vladaviedov/frequency-counter/README.md

# Frequency Counter

Design files & firmware for my [frequency counter
project](https://vladaviedov.org/project/frequency_counter.html)
