vladaviedov/frequency-counter/kicad/frequency_counter.kicad_pcb

## KiCad design kicad/frequency_counter.kicad_pcb (2026-02-19)

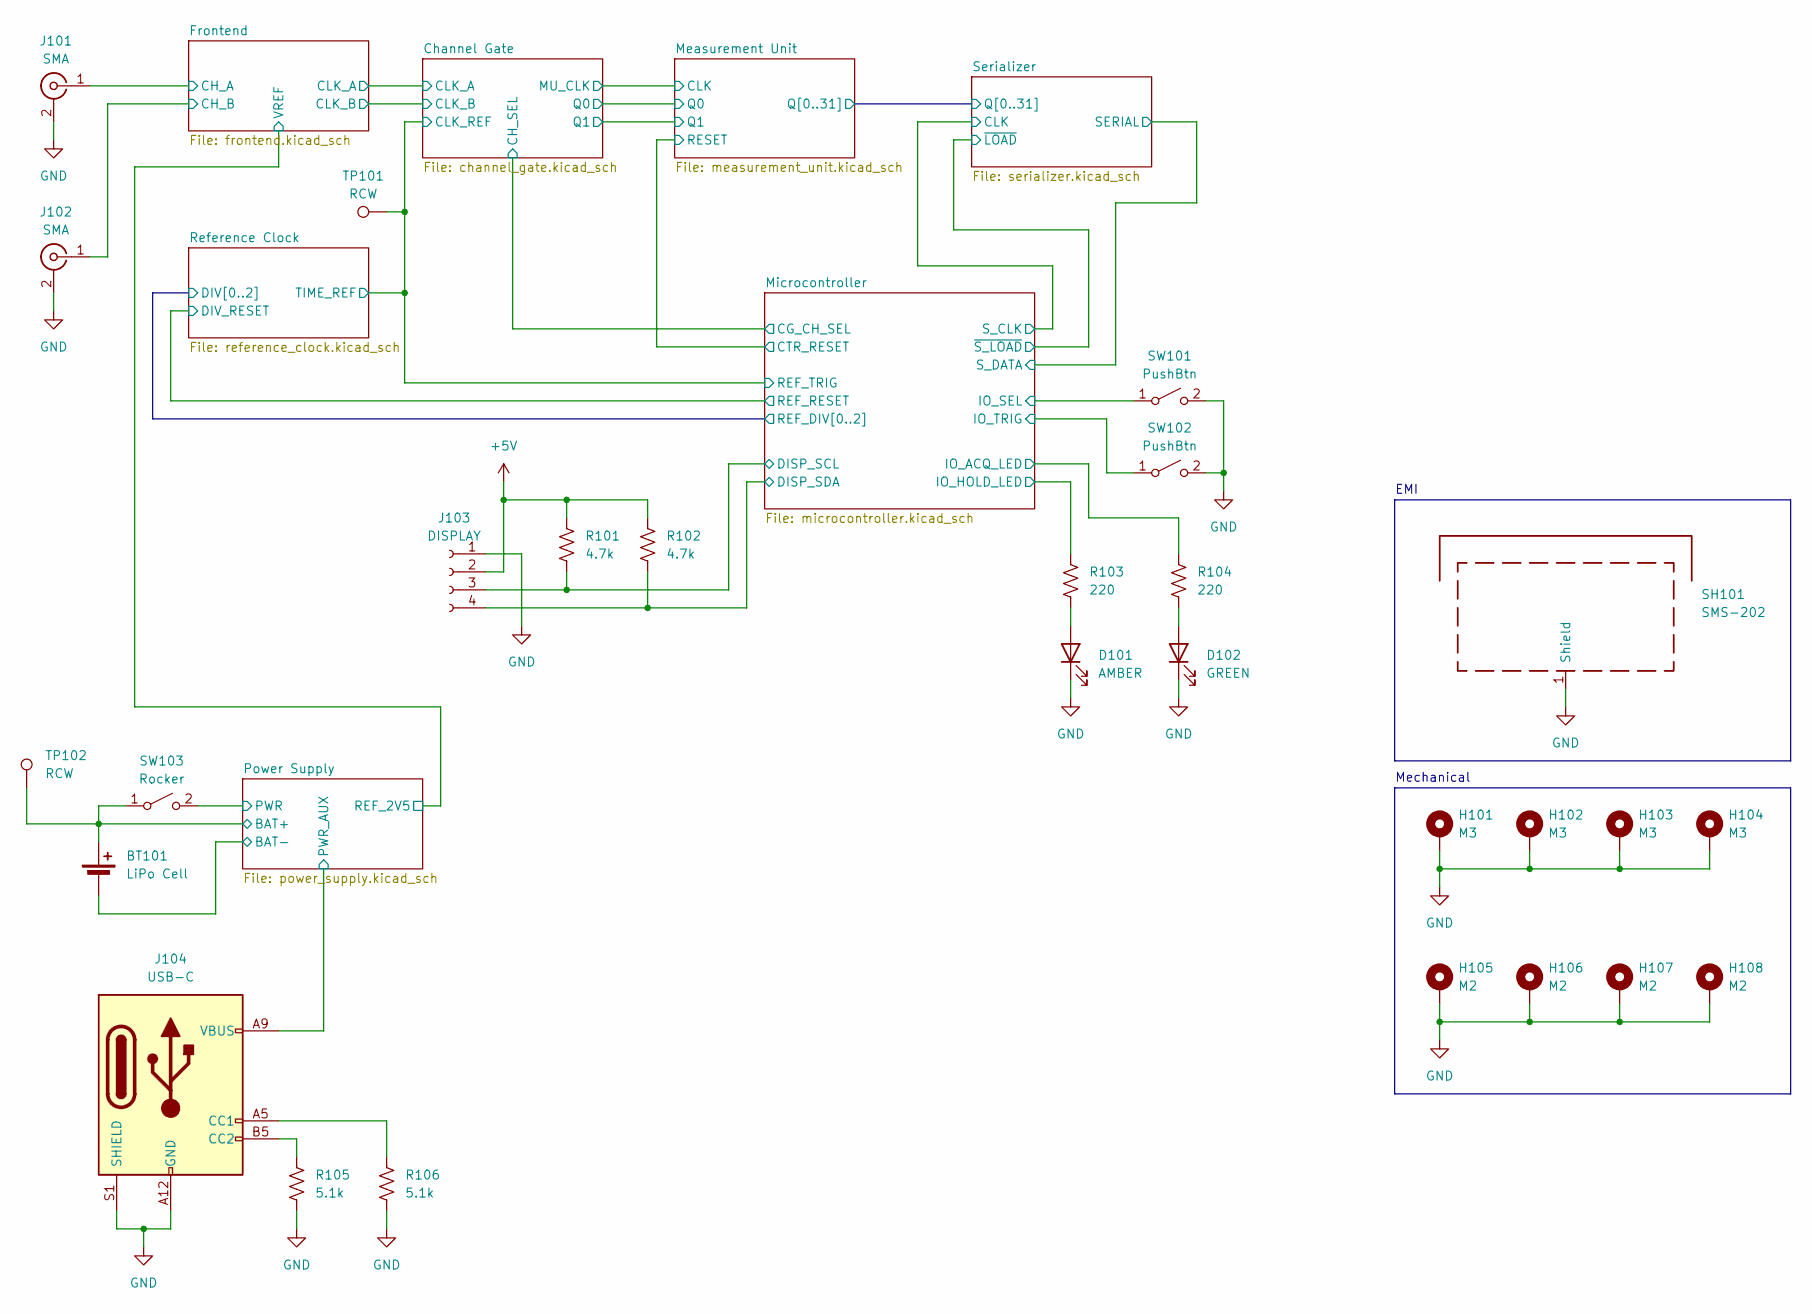
[picture p1: schematic frequency_counter.kicad_sch, Frequency Counter]

Parts:
BT101: LiPo Cell; JST_ZH_B2B-ZR_1x02_P1.50mm_Vertical
D101: AMBER; LED_0603_1608Metric; MPN B1911UY--20D000114U1930
D102: GREEN; LED_0603_1608Metric; MPN B1911NG--20D000214U1930
H101, H102, H103, H104: M3; MountingHole_3.2mm_M3_Pad
H105, H106, H107, H108: M2; MountingHole_2.2mm_M2_Pad
J101, J102: SMA; SMA_Adjusted; MPN CON-SMA-EDGE-S
J103: DISPLAY; PinHeader_1x04_P2.54mm_Vertical
J104: USB-C; USB_C_Receptacle_GCT_USB4125-xx-x_6P_TopMnt_Horizontal; MPN USB4125-GF-A
R101, R102: 4.7k; R_0402_1005Metric_Fix; MPN RC0402JR-074K7L
R103, R104: 220; R_0402_1005Metric_Fix; MPN RC0402JR-13220RL
R105, R106: 5.1k; R_0402_1005Metric_Fix; MPN RC0402JR-135K1L
SH101: SMS-202; Laird_Technologies_BMI-S-202-F_16.50x16.50mm; MPN SMS-201F
SW101, SW102: PushBtn; SW_Push_1P1T_NO_E-Switch_TL3301NxxxxxG; MPN 2-1977223-4
SW103: Rocker; SolderWire-1.5sqmm_1x02_P6mm_D1.7mm_OD3mm
TP101, TP102: RCW; TestPoint_KOA_RCW; MPN RCWCTE

Connections:
+5V: J103.2, R101.1, R102.1; also elsewhere on the board
/Channel Gate/CLK_REF: TP101.1; also elsewhere on the board
/Frontend/CH_A: J101.1 (In); also elsewhere on the board
/Frontend/CH_B: J102.1 (In); also elsewhere on the board
/Microcontroller/DISP_SCL: J103.3, R101.2; also elsewhere on the board
/Microcontroller/DISP_SDA: J103.4, R102.2; also elsewhere on the board
/Microcontroller/IO_ACQ_LED: R104.1; also elsewhere on the board
/Microcontroller/IO_HOLD_LED: R103.1; also elsewhere on the board
/Microcontroller/IO_SEL: SW101.1 (A); also elsewhere on the board
/Microcontroller/IO_TRIG: SW102.1 (A); also elsewhere on the board
/Power Supply/BAT+: BT101.1 (+), SW103.1 (A), TP102.1; also elsewhere on the board
/Power Supply/BAT-: BT101.2 (-); also elsewhere on the board
/Power Supply/PWR: SW103.2 (B); also elsewhere on the board
/Power Supply/PWR_AUX: J104.A9 (VBUS), J104.B9 (VBUS); also elsewhere on the board
GND: D101.1 (K), D102.1 (K), H101.1, H102.1, H103.1, H104.1, H105.1, H106.1, H107.1, H108.1, J101.2 (Ext), J102.2 (Ext), J103.1, J104.A12 (GND), J104.B12 (GND), J104.S1 (SHIELD), R105.2, R106.2, SH101.1 (Shield), SW101.2 (B), SW102.2 (B); also elsewhere on the board
unnamed: D101.2 (A), R103.2
unnamed: D102.2 (A), R104.2
unnamed: J104.A5 (CC1), R106.1
unnamed: J104.B5 (CC2), R105.1

Notes on the sheet:
Mechanical
EMI

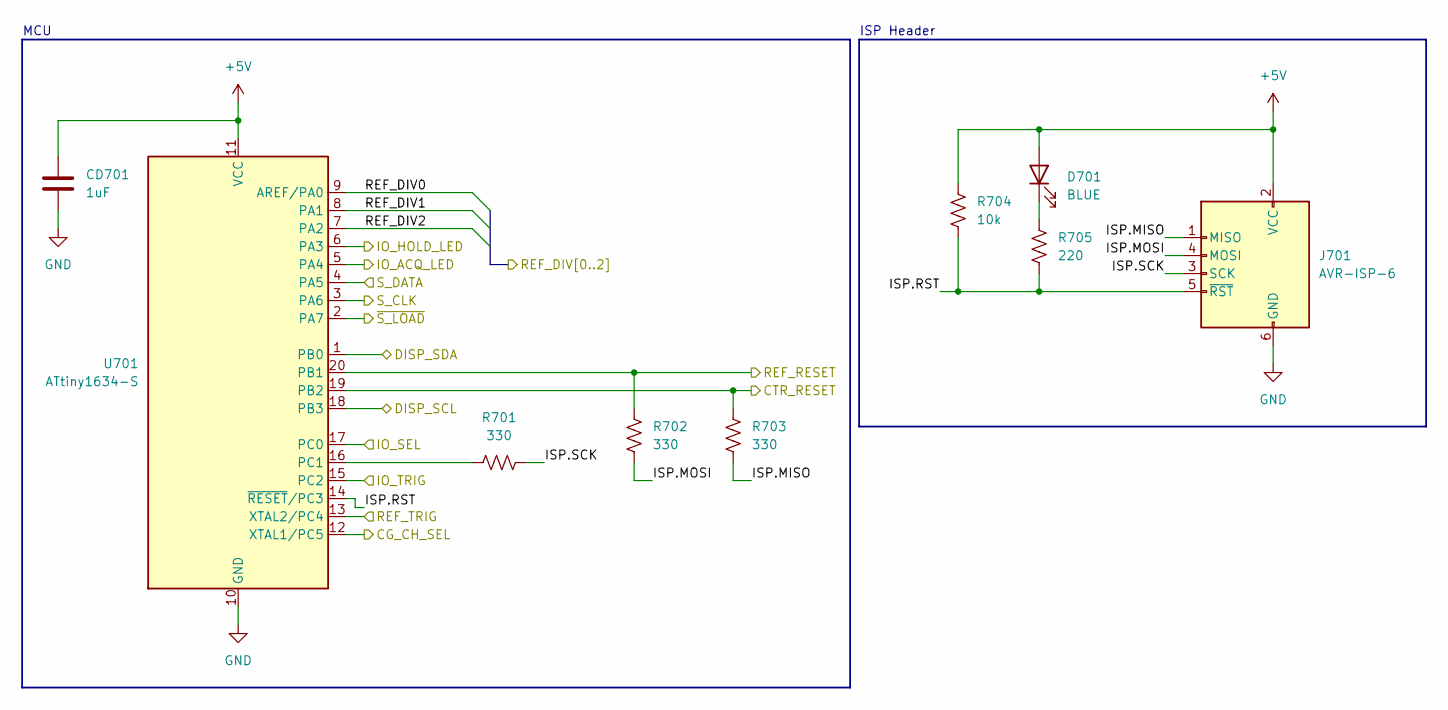
[picture p2: schematic microcontroller.kicad_sch, Frequency Counter]

Parts:
CD701: 1uF; C_0402_1005Metric_Fix; MPN 0402ZD105KAT2A
D701: BLUE; LED_0603_1608Metric; MPN E1221NB--05D000814U1930
J701: AVR-ISP-6; IDC-Header_2x03_P2.54mm_Vertical
R701, R702, R703: 330; R_0402_1005Metric_Fix; MPN RC0402JR-13330RL
R704: 10k; R_0402_1005Metric_Fix; MPN RC0402JR-1310KL
R705: 220; R_0402_1005Metric_Fix; MPN RC0402JR-13220RL
U701: ATtiny1634-S; SOIC-20W_7.5x12.8mm_P1.27mm; MPN ATTINY1634-SU

Connections:
+5V: CD701.1, D701.2 (A), J701.2 (VCC), R704.1, U701.11 (VCC); also elsewhere on the board
/Channel Gate/CH_SEL: U701.12 (XTAL1/PC5); also elsewhere on the board
/Channel Gate/CLK_REF: U701.13 (XTAL2/PC4); also elsewhere on the board
/Measurement Unit/RESET: R703.2, U701.19 (PB2); also elsewhere on the board
/Microcontroller/DISP_SCL: U701.18 (PB3); also elsewhere on the board
/Microcontroller/DISP_SDA: U701.1 (PB0); also elsewhere on the board
/Microcontroller/IO_ACQ_LED: U701.5 (PA4); also elsewhere on the board
/Microcontroller/IO_HOLD_LED: U701.6 (PA3); also elsewhere on the board
/Microcontroller/IO_SEL: U701.17 (PC0); also elsewhere on the board
/Microcontroller/IO_TRIG: U701.15 (PC2); also elsewhere on the board
/Microcontroller/ISP.MISO: J701.1 (MISO), R703.1
/Microcontroller/ISP.MOSI: J701.4 (MOSI), R702.2
/Microcontroller/ISP.RST: J701.5 (~RST), R704.2, R705.1, U701.14 (~RESET/PC3)
/Microcontroller/ISP.SCK: J701.3 (SCK), R701.1
/Microcontroller/REF_DIV0: U701.9 (AREF/PA0); also elsewhere on the board
/Microcontroller/REF_DIV1: U701.8 (PA1); also elsewhere on the board
/Microcontroller/REF_DIV2: U701.7 (PA2); also elsewhere on the board
/Microcontroller/REF_RESET: R702.1, U701.20 (PB1); also elsewhere on the board
/Microcontroller/S_CLK: U701.3 (PA6); also elsewhere on the board
/Microcontroller/S_DATA: U701.4 (PA5); also elsewhere on the board
/Microcontroller/~S_LOAD: U701.2 (PA7); also elsewhere on the board
GND: CD701.2, J701.6 (GND), U701.10 (GND); also elsewhere on the board
unnamed: D701.1 (K), R705.2
unnamed: R701.2, U701.16 (PC1)

Notes on the sheet:
MCU
ISP Header

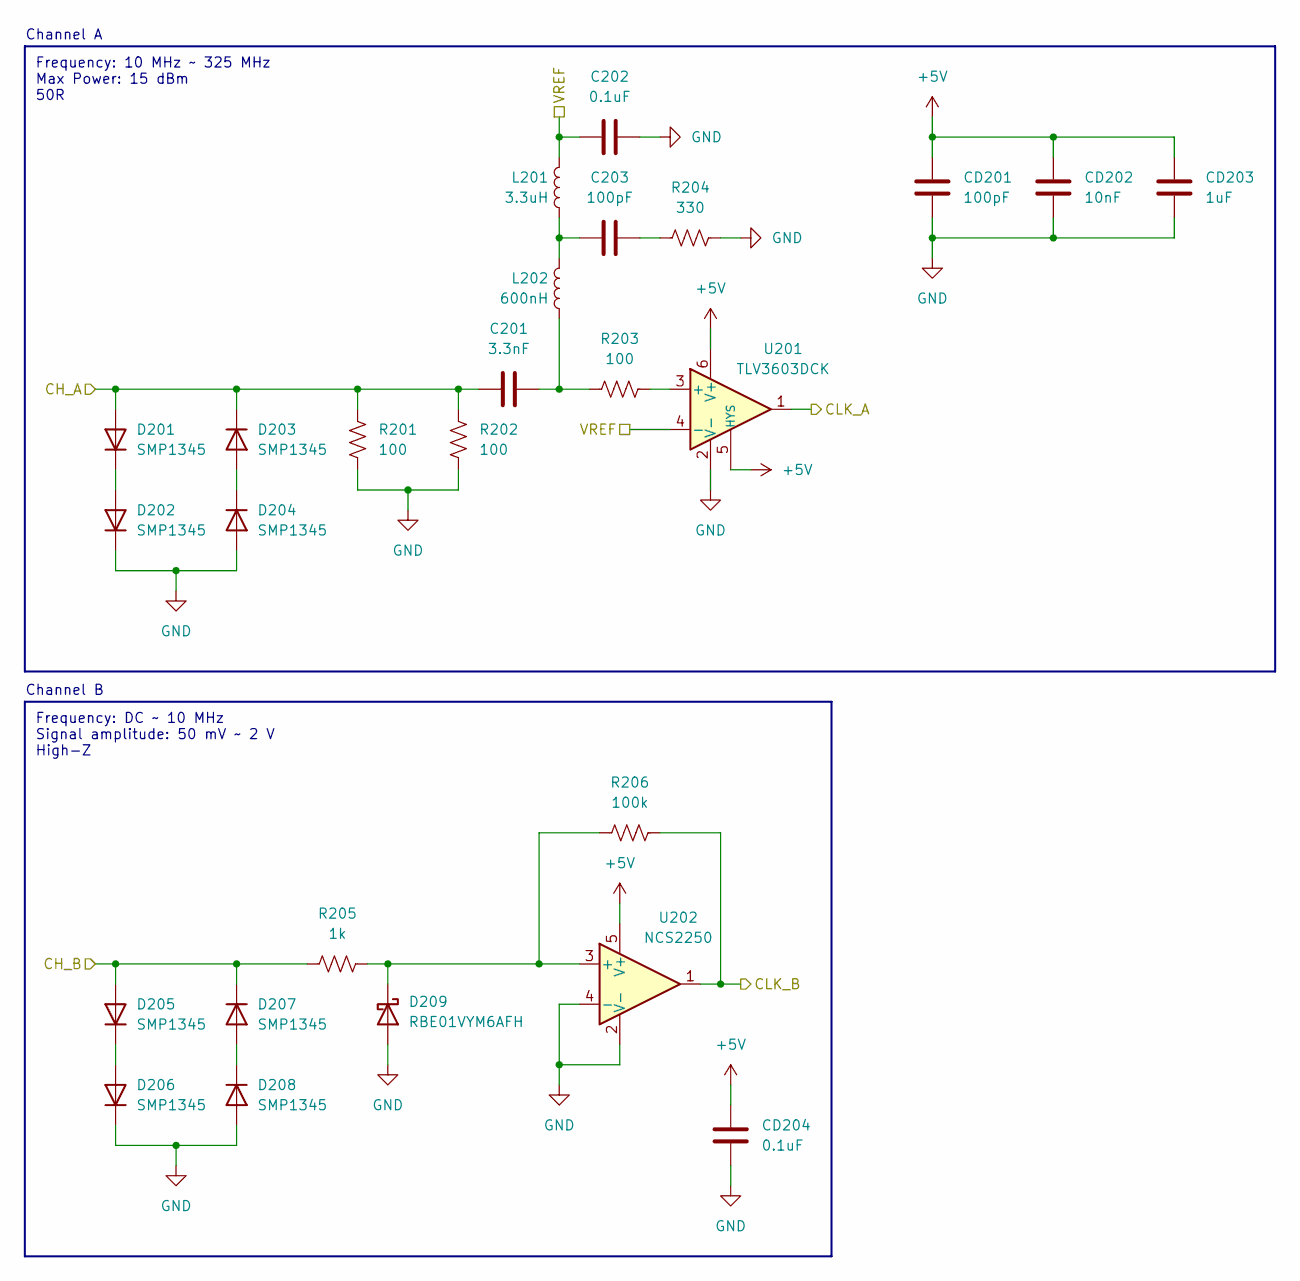
[picture p3: schematic frontend.kicad_sch, Frequency Counter]

Parts:
C201: 3.3nF; C_0402_1005Metric_Fix; MPN GRM1555C1H332JE01D
C202: 0.1uF; C_0402_1005Metric_Fix; MPN KGM05AR51C104KH
C203: 100pF; C_0402_1005Metric_Fix; MPN CC0402JRNPO9BN101
CD201: 100pF; C_0402_1005Metric_Fix; MPN CC0402JRNPO9BN101
CD202: 10nF; C_0402_1005Metric_Fix; MPN GRM155R71C103KA01D
CD203: 1uF; C_0402_1005Metric_Fix; MPN 0402ZD105KAT2A
CD204: 0.1uF; C_0402_1005Metric_Fix; MPN KGM05AR51C104KH
D201, D202, D203, D204, D205, D206, D207, D208: SMP1345; D_0402_1005Metric_Pad0.77x0.64mm_HandSolder; MPN SMP1345-040LF
D209: RBE01VYM6AFH; D_SOD-323_HandSoldering; MPN RBE01VYM6AFHTR
L201: 3.3uH; L_0805_2012Metric; MPN BRC2012T3R3MD
L202: 600nH; L_0603_1608Metric; MPN 7447610260
R201, R202: 100; R_1206_3216Metric; MPN RT1206BRE07100RL
R203: 100; R_0402_1005Metric_Fix; MPN RC0402JR-07100RL
R204: 330; R_0402_1005Metric_Fix; MPN RC0402JR-13330RL
R205: 1k; R_0402_1005Metric_Fix; MPN RC0402JR-071KL
R206: 100k; R_0402_1005Metric_Fix; MPN RC0402JR-07100RL
U201: TLV3603DCK; SOT-363_SC-70-6; MPN TLV3603DCKR
U202: NCS2250; TSOP-5_1.65x3.05mm_P0.95mm; MPN NCS2250SN2T1G

Connections:
+5V: CD201.1, CD202.1, CD203.1, CD204.1, U201.5 (HYS), U201.6 (V+), U202.5 (V+); also elsewhere on the board
/Channel Gate/CLK_A: U201.1; also elsewhere on the board
/Channel Gate/CLK_B: R206.2, U202.1; also elsewhere on the board
/Frontend/CH_A: C201.1, D201.2 (A), D203.1 (K), R201.2, R202.2; also elsewhere on the board
/Frontend/CH_B: D205.2 (A), D207.1 (K), R205.1; also elsewhere on the board
/Frontend/VREF: C202.1, L201.1, U201.4 (-); also elsewhere on the board
GND: C202.2, CD201.2, CD202.2, CD203.2, CD204.2, D202.1 (K), D204.2 (A), D206.1 (K), D208.2 (A), D209.2 (A), R201.1, R202.1, R204.2, U201.2 (V-), U202.2 (V-), U202.4 (-); also elsewhere on the board
unnamed: C201.2, L202.2, R203.1
unnamed: C203.1, L201.2, L202.1
unnamed: C203.2, R204.1
unnamed: D201.1 (K), D202.2 (A)
unnamed: D203.2 (A), D204.1 (K)
unnamed: D205.1 (K), D206.2 (A)
unnamed: D207.2 (A), D208.1 (K)
unnamed: D209.1 (K), R205.2, R206.1, U202.3 (+)
unnamed: R203.2, U201.3 (+)

Notes on the sheet:
Frequency: 10 MHz ~ 325 MHz Max Power: 15 dBm 50R
Channel B
Channel A
Frequency: DC ~ 10 MHz Signal amplitude: 50 mV ~ 2 V High-Z

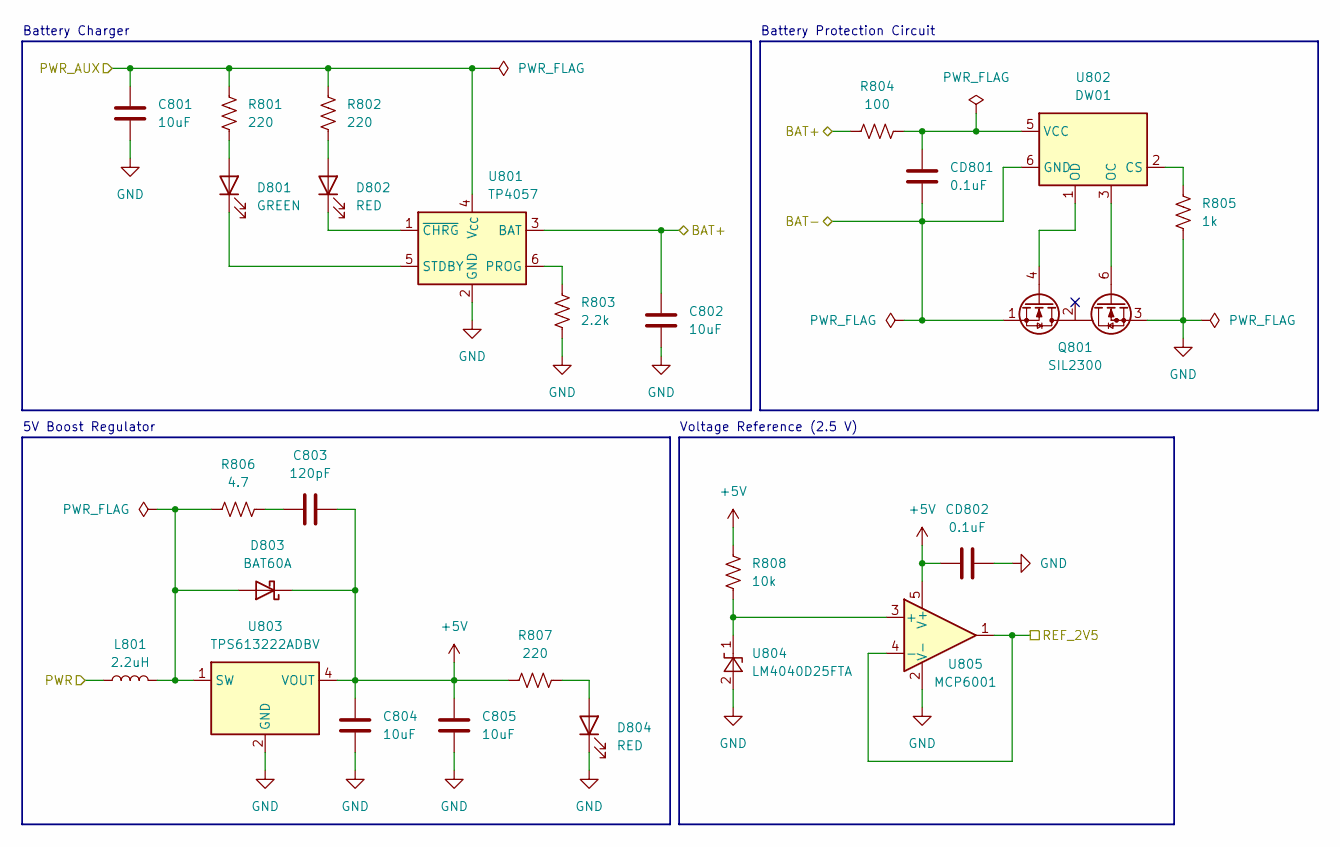
[picture p4: schematic power_supply.kicad_sch, Frequency Counter]

Parts:
C801, C802, C804, C805: 10uF; C_0603_1608Metric; MPN CL10A106KP8NNNC
C803: 120pF; C_0402_1005Metric_Fix; MPN GRM1555C1H121JA01D
CD801, CD802: 0.1uF; C_0402_1005Metric_Fix; MPN KGM05AR51C104KH
D801: GREEN; LED_0603_1608Metric; MPN B1911NG--20D000214U1930
D802, D804: RED; LED_0603_1608Metric; MPN B1911USD-20D000114U1930
D803: BAT60A; D_SOD-323; MPN BAT60A
L801: 2.2uH; L_1008_2520Metric; MPN DFE252012F-2R2M=P2
Q801: SIL2300; SOT-23-6; MPN SIL2300-TP
R801, R802, R807: 220; R_0402_1005Metric_Fix; MPN RC0402JR-13220RL
R803: 2.2k; R_0402_1005Metric_Fix; MPN RC0402JR-132K2L
R804: 100; R_0402_1005Metric_Fix; MPN RC0402JR-07100RL
R805: 1k; R_0402_1005Metric_Fix; MPN RC0402JR-071KL
R806: 4.7; R_0805_2012Metric; MPN RC0805FR-134R7L
R808: 10k; R_0402_1005Metric_Fix; MPN RC0402JR-1310KL
U801: TP4057; TSOT-23-6; MPN TP4057TP4057
U802: DW01; SOT-23-6; MPN DW01
U803: TPS613222ADBV; SOT-23-5; MPN TPS613222ADBVR
U804: LM4040D25FTA; SOT-23-3; MPN LM4040D25FTA
U805: MCP6001; SOT-353_SC-70-5; MPN MCP6001T-I/OT

Connections:
+5V: C803.2, C804.1, C805.1, CD802.1, D803.1 (K), R807.1, R808.1, U803.4 (VOUT), U805.5 (V+); also elsewhere on the board
/Frontend/VREF: U805.1, U805.4 (-); also elsewhere on the board
/Power Supply/BAT+: C802.1, R804.1, U801.3 (BAT); also elsewhere on the board
/Power Supply/BAT-: CD801.2, Q801.1 (S1), U802.6 (GND); also elsewhere on the board
/Power Supply/PWR: L801.1; also elsewhere on the board
/Power Supply/PWR_AUX: C801.1, R801.1, R802.1, U801.4 (V_{CC}); also elsewhere on the board
GND: C801.2, C802.2, C804.2, C805.2, CD802.2, D804.1 (K), Q801.3 (S2), R803.2, R805.1, U801.2 (GND), U803.2 (GND), U804.2 (A), U805.2 (V-); also elsewhere on the board
unnamed: C803.1, R806.2
unnamed: D801.2 (A), R801.2
unnamed: D801.1 (K), U801.5 (STDBY)
unnamed: D802.2 (A), R802.2
unnamed: D802.1 (K), U801.1 (~CHRG)
unnamed: D803.2 (A), L801.2, R806.1, U803.1 (SW)
unnamed: D804.2 (A), R807.2
unnamed: Q801.4 (G1), U802.1 (OD)
unnamed: Q801.6 (G2), U802.3 (OC)
unnamed: R803.1, U801.6 (PROG)
unnamed: R805.2, U802.2 (CS)
unnamed: CD801.1, R804.2, U802.5 (VCC)
unnamed: R808.2, U804.1 (K), U805.3 (+)

Notes on the sheet:
5V Boost Regulator
Battery Protection Circuit
Voltage Reference (2.5 V)
Battery Charger

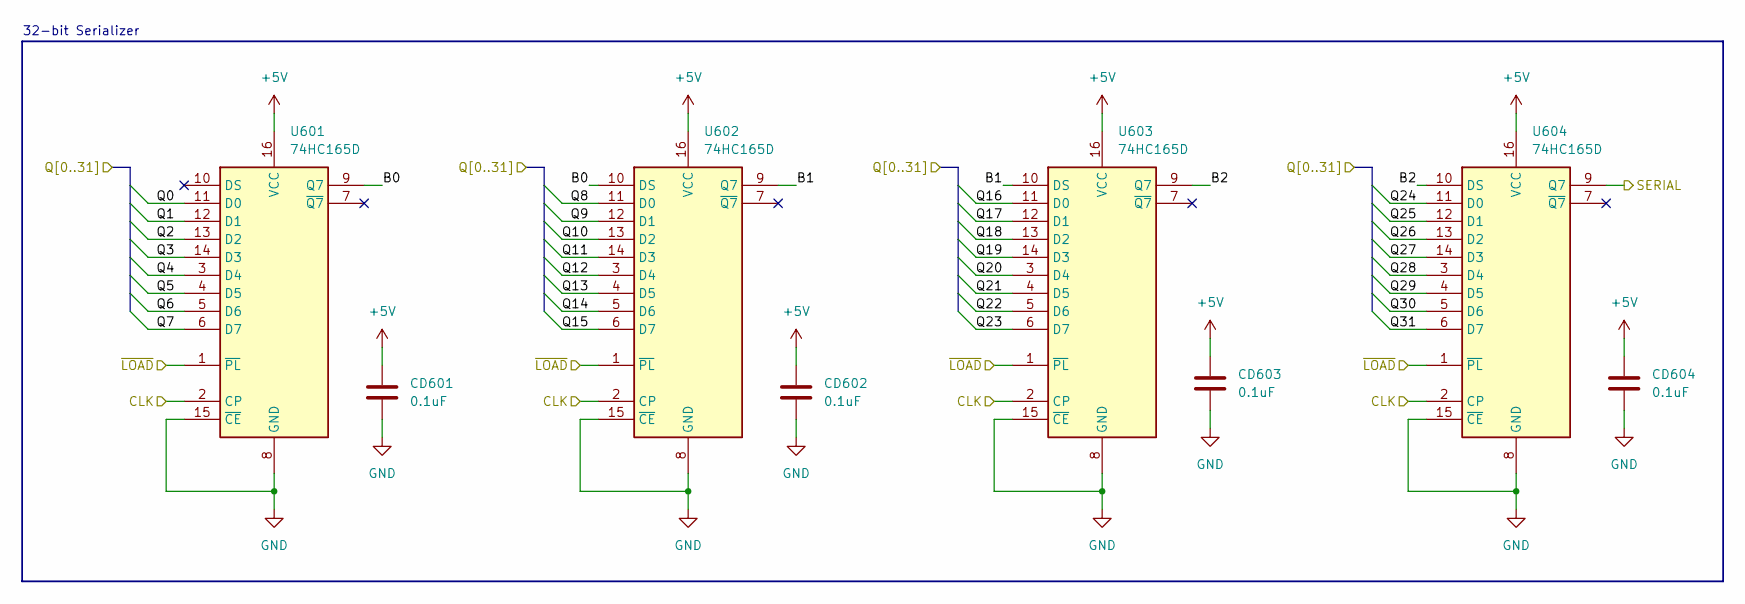
[picture p5: schematic serializer.kicad_sch, Frequency Counter]

Parts:
CD601, CD602, CD603, CD604: 0.1uF; C_0402_1005Metric_Fix; MPN KGM05AR51C104KH
U601, U602, U603, U604: 74HC165D; SO-16_3.9x9.9mm_P1.27mm; MPN 74HC165D,653

Connections:
+5V: CD601.1, CD602.1, CD603.1, CD604.1, U601.16 (VCC), U602.16 (VCC), U603.16 (VCC), U604.16 (VCC); also elsewhere on the board
/Measurement Unit/Q0: U601.11 (D0); also elsewhere on the board
/Measurement Unit/Q1: U601.12 (D1); also elsewhere on the board
/Measurement Unit/Q2: U601.13 (D2); also elsewhere on the board
/Measurement Unit/Q3: U601.14 (D3); also elsewhere on the board
/Measurement Unit/Q4: U601.3 (D4); also elsewhere on the board
/Measurement Unit/Q5: U601.4 (D5); also elsewhere on the board
/Measurement Unit/Q6: U601.5 (D6); also elsewhere on the board
/Measurement Unit/Q7: U601.6 (D7); also elsewhere on the board
/Measurement Unit/Q8: U602.11 (D0); also elsewhere on the board
/Measurement Unit/Q9: U602.12 (D1); also elsewhere on the board
/Measurement Unit/Q10: U602.13 (D2); also elsewhere on the board
/Measurement Unit/Q11: U602.14 (D3); also elsewhere on the board
/Measurement Unit/Q12: U602.3 (D4); also elsewhere on the board
/Measurement Unit/Q13: U602.4 (D5); also elsewhere on the board
/Measurement Unit/Q14: U602.5 (D6); also elsewhere on the board
/Measurement Unit/Q15: U602.6 (D7); also elsewhere on the board
/Measurement Unit/Q16: U603.11 (D0); also elsewhere on the board
/Measurement Unit/Q17: U603.12 (D1); also elsewhere on the board
/Measurement Unit/Q18: U603.13 (D2); also elsewhere on the board
/Measurement Unit/Q19: U603.14 (D3); also elsewhere on the board
/Measurement Unit/Q20: U603.3 (D4); also elsewhere on the board
/Measurement Unit/Q21: U603.4 (D5); also elsewhere on the board
/Measurement Unit/Q22: U603.5 (D6); also elsewhere on the board
/Measurement Unit/Q23: U603.6 (D7); also elsewhere on the board
/Measurement Unit/Q24: U604.11 (D0); also elsewhere on the board
/Measurement Unit/Q25: U604.12 (D1); also elsewhere on the board
/Measurement Unit/Q26: U604.13 (D2); also elsewhere on the board
/Measurement Unit/Q27: U604.14 (D3); also elsewhere on the board
/Measurement Unit/Q28: U604.3 (D4); also elsewhere on the board
/Measurement Unit/Q29: U604.4 (D5); also elsewhere on the board
/Measurement Unit/Q30: U604.5 (D6); also elsewhere on the board
/Measurement Unit/Q31: U604.6 (D7); also elsewhere on the board
/Microcontroller/S_CLK: U601.2 (CP), U602.2 (CP), U603.2 (CP), U604.2 (CP); also elsewhere on the board
/Microcontroller/S_DATA: U604.9 (Q7); also elsewhere on the board
/Microcontroller/~S_LOAD: U601.1 (~PL), U602.1 (~PL), U603.1 (~PL), U604.1 (~PL); also elsewhere on the board
/Serializer/B0: U601.9 (Q7), U602.10 (DS)
/Serializer/B1: U602.9 (Q7), U603.10 (DS)
/Serializer/B2: U603.9 (Q7), U604.10 (DS)
GND: CD601.2, CD602.2, CD603.2, CD604.2, U601.8 (GND), U601.15 (~CE), U602.8 (GND), U602.15 (~CE), U603.8 (GND), U603.15 (~CE), U604.8 (GND), U604.15 (~CE); also elsewhere on the board

Notes on the sheet:
32-bit Serializer

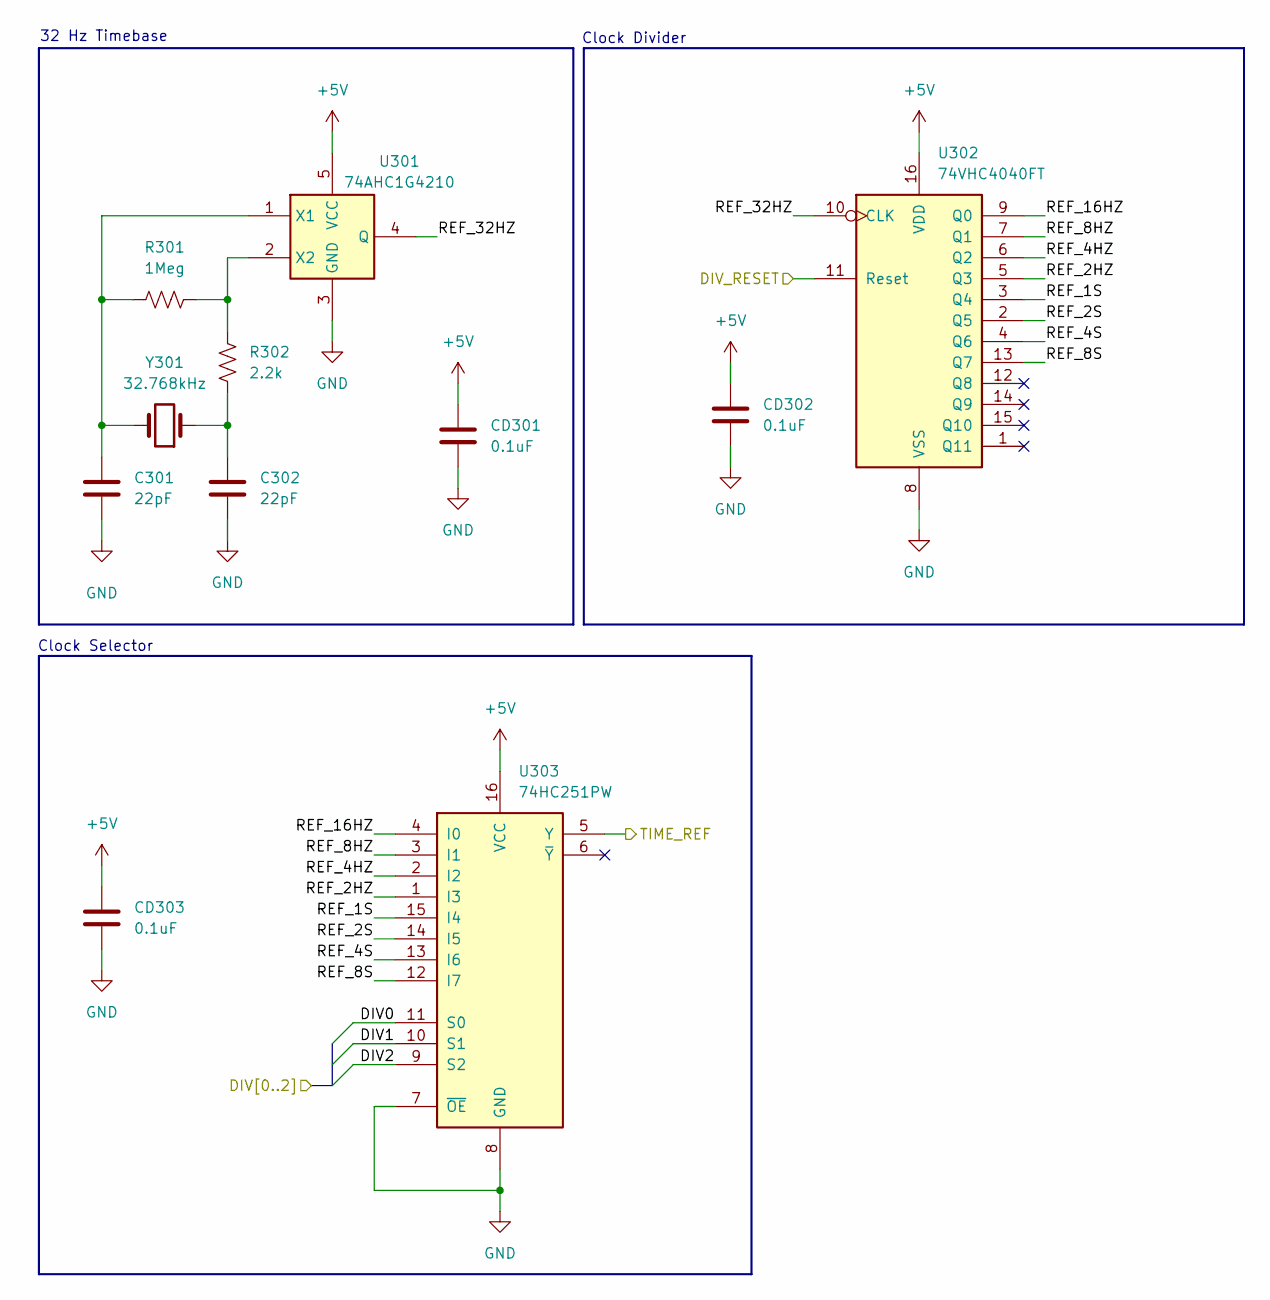
[picture p6: schematic reference_clock.kicad_sch, Frequency Counter]

Parts:
C301, C302: 22pF; C_0402_1005Metric_Fix; MPN GRM1555C1H220JA01D
CD301, CD302, CD303: 0.1uF; C_0402_1005Metric_Fix; MPN KGM05AR51C104KH
R301: 1Meg; R_0402_1005Metric_Fix; MPN RC0402FR-071ML
R302: 2.2k; R_0402_1005Metric_Fix; MPN RC0402JR-132K2L
U301: 74AHC1G4210; SOT-353_SC-70-5; MPN 74AHC1G4210GWH
U302: 74VHC4040FT; TSSOP-16_4.4x5mm_P0.65mm; MPN 74VHC4040FT
U303: 74HC251PW; TSSOP-16_4.4x5mm_P0.65mm; MPN 74HC251PW,118
Y301: 32.768kHz; Crystal_SMD_EuroQuartz_EQ161-2Pin_3.2x1.5mm_HandSoldering; MPN CM315D32768HZFT

Connections:
+5V: CD301.1, CD302.1, CD303.1, U301.5 (VCC), U302.16 (VDD), U303.16 (VCC); also elsewhere on the board
/Channel Gate/CLK_REF: U303.5 (Y); also elsewhere on the board
/Microcontroller/REF_DIV0: U303.11 (S0); also elsewhere on the board
/Microcontroller/REF_DIV1: U303.10 (S1); also elsewhere on the board
/Microcontroller/REF_DIV2: U303.9 (S2); also elsewhere on the board
/Microcontroller/REF_RESET: U302.11 (Reset); also elsewhere on the board
/Reference Clock/REF_1S: U302.3 (Q4), U303.15 (I4)
/Reference Clock/REF_2HZ: U302.5 (Q3), U303.1 (I3)
/Reference Clock/REF_2S: U302.2 (Q5), U303.14 (I5)
/Reference Clock/REF_4HZ: U302.6 (Q2), U303.2 (I2)
/Reference Clock/REF_4S: U302.4 (Q6), U303.13 (I6)
/Reference Clock/REF_8HZ: U302.7 (Q1), U303.3 (I1)
/Reference Clock/REF_8S: U302.13 (Q7), U303.12 (I7)
/Reference Clock/REF_16HZ: U302.9 (Q0), U303.4 (I0)
/Reference Clock/REF_32HZ: U301.4 (Q), U302.10 (CLK)
GND: C301.2, C302.2, CD301.2, CD302.2, CD303.2, U301.3 (GND), U302.8 (VSS), U303.7 (~OE), U303.8 (GND); also elsewhere on the board
unnamed: C302.1, R302.2, Y301.1
unnamed: C301.1, R301.1, U301.1 (X1), Y301.2
unnamed: R301.2, R302.1, U301.2 (X2)

Notes on the sheet:
Clock Divider
32 Hz Timebase
Clock Selector

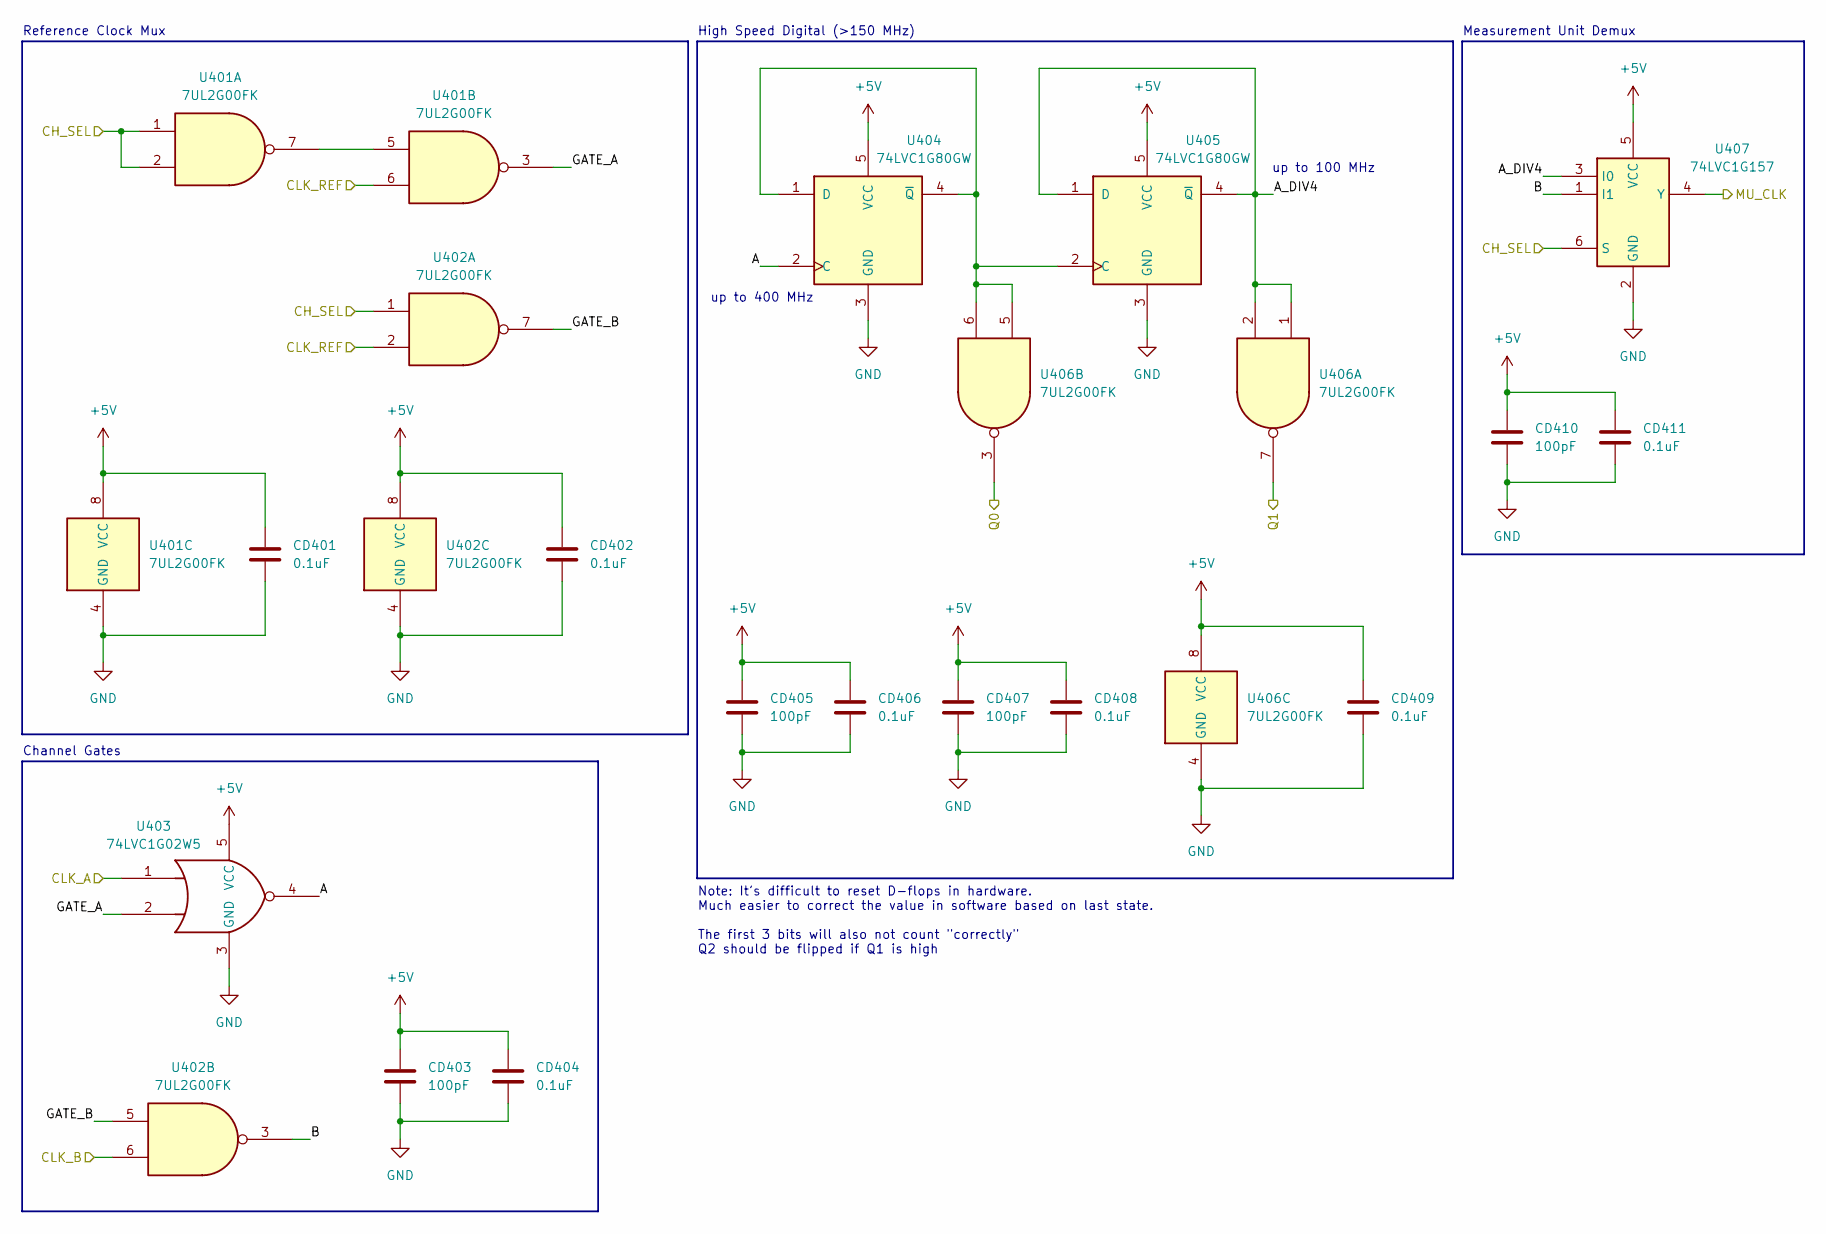
[picture p7: schematic channel_gate.kicad_sch, Frequency Counter]

Parts:
CD401, CD402, CD404, CD406, CD408, CD409, CD411: 0.1uF; C_0402_1005Metric_Fix; MPN KGM05AR51C104KH
CD403, CD405, CD407, CD410: 100pF; C_0402_1005Metric_Fix; MPN CC0402JRNPO9BN101
U401, U402, U406: 7UL2G00FK; VSSOP-8_2.3x2mm_P0.5mm; MPN 7UL2G00FK,LF
U403: 74LVC1G02W5; SC-74A-5_1.55x2.9mm_P0.95mm; MPN 74LVC1G02W5-7
U404, U405: 74LVC1G80GW; SOT-353_SC-70-5; MPN 74LVC1G80GW,125
U407: 74LVC1G157; TSOP-6_1.65x3.05mm_P0.95mm; MPN 74LVC1G157GW,125

Connections:
+5V: CD401.1, CD402.1, CD403.1, CD404.1, CD405.1, CD406.1, CD407.1, CD408.1, CD409.1, CD410.1, CD411.1, U401.8 (VCC), U402.8 (VCC), U403.5 (VCC), U404.5 (VCC), U405.5 (VCC), U406.8 (VCC), U407.5 (VCC); also elsewhere on the board
/Channel Gate/A: U403.4, U404.2 (C)
/Channel Gate/A_DIV4: U405.1 (D), U405.4 (~Q), U406.1, U406.2, U407.3 (I0)
/Channel Gate/B: U402.3, U407.1 (I1)
/Channel Gate/CH_SEL: U401.1, U401.2, U402.1, U407.6 (S); also elsewhere on the board
/Channel Gate/CLK_A: U403.1; also elsewhere on the board
/Channel Gate/CLK_B: U402.6; also elsewhere on the board
/Channel Gate/CLK_REF: U401.6, U402.2; also elsewhere on the board
/Channel Gate/GATE_A: U401.3, U403.2
/Channel Gate/GATE_B: U402.5, U402.7
/Channel Gate/MU_CLK: U407.4 (Y); also elsewhere on the board
/Measurement Unit/Q0: U406.3; also elsewhere on the board
/Measurement Unit/Q1: U406.7; also elsewhere on the board
GND: CD401.2, CD402.2, CD403.2, CD404.2, CD405.2, CD406.2, CD407.2, CD408.2, CD409.2, CD410.2, CD411.2, U401.4 (GND), U402.4 (GND), U403.3 (GND), U404.3 (GND), U405.3 (GND), U406.4 (GND), U407.2 (GND); also elsewhere on the board
unnamed: U401.5, U401.7
unnamed: U404.1 (D), U404.4 (~Q), U405.2 (C), U406.5, U406.6

Notes on the sheet:
High Speed Digital (>150 MHz)
Channel Gates
up to 400 MHz
Note: It's difficult to reset D-flops in hardware. Much easier to correct the value in software based on last state. The first 3 bits will also not count "correctly" Q2 should be flipped if Q1 is high
up to 100 MHz
Measurement Unit Demux
Reference Clock Mux
