vladaviedov/frequency-counter/kicad/frequency_counter.kicad_pcb

## KiCad design kicad/frequency_counter.kicad_pcb (continued)

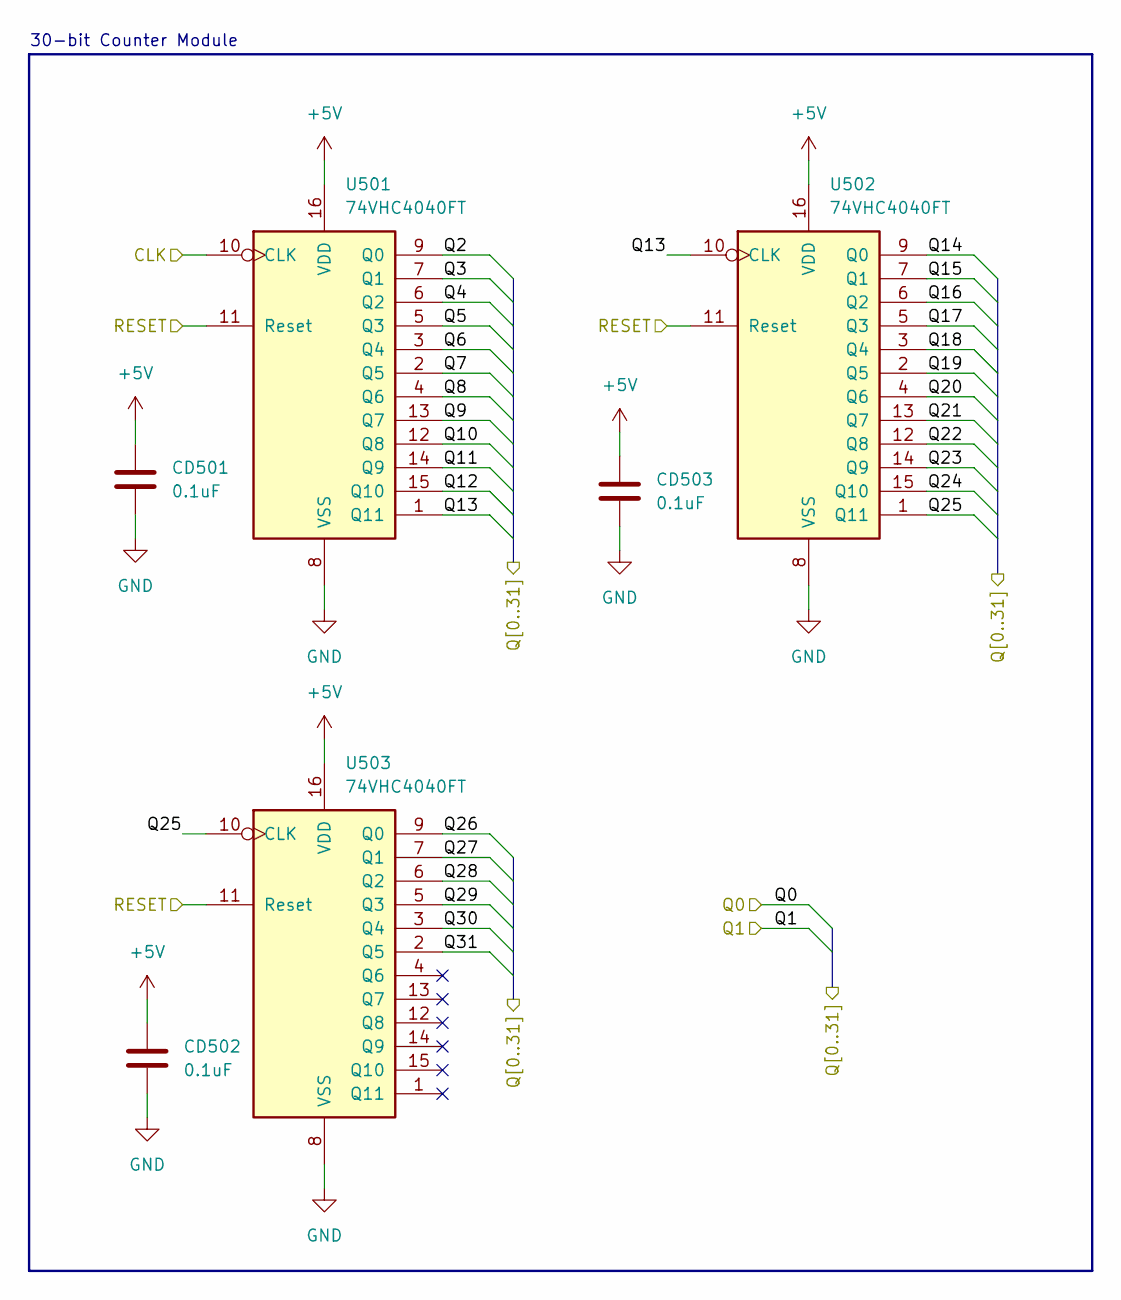
[picture p8: schematic measurement_unit.kicad_sch, Frequency Counter]

Parts:
CD501, CD502, CD503: 0.1uF; C_0402_1005Metric_Fix; MPN KGM05AR51C104KH
U501, U502, U503: 74VHC4040FT; TSSOP-16_4.4x5mm_P0.65mm; MPN 74VHC4040FT

Connections:
+5V: CD501.1, CD502.1, CD503.1, U501.16 (VDD), U502.16 (VDD), U503.16 (VDD); also elsewhere on the board
/Channel Gate/MU_CLK: U501.10 (CLK); also elsewhere on the board
/Measurement Unit/Q2: U501.9 (Q0); also elsewhere on the board
/Measurement Unit/Q3: U501.7 (Q1); also elsewhere on the board
/Measurement Unit/Q4: U501.6 (Q2); also elsewhere on the board
/Measurement Unit/Q5: U501.5 (Q3); also elsewhere on the board
/Measurement Unit/Q6: U501.3 (Q4); also elsewhere on the board
/Measurement Unit/Q7: U501.2 (Q5); also elsewhere on the board
/Measurement Unit/Q8: U501.4 (Q6); also elsewhere on the board
/Measurement Unit/Q9: U501.13 (Q7); also elsewhere on the board
/Measurement Unit/Q10: U501.12 (Q8); also elsewhere on the board
/Measurement Unit/Q11: U501.14 (Q9); also elsewhere on the board
/Measurement Unit/Q12: U501.15 (Q10); also elsewhere on the board
/Measurement Unit/Q13: U501.1 (Q11), U502.10 (CLK); also elsewhere on the board
/Measurement Unit/Q14: U502.9 (Q0); also elsewhere on the board
/Measurement Unit/Q15: U502.7 (Q1); also elsewhere on the board
/Measurement Unit/Q16: U502.6 (Q2); also elsewhere on the board
/Measurement Unit/Q17: U502.5 (Q3); also elsewhere on the board
/Measurement Unit/Q18: U502.3 (Q4); also elsewhere on the board
/Measurement Unit/Q19: U502.2 (Q5); also elsewhere on the board
/Measurement Unit/Q20: U502.4 (Q6); also elsewhere on the board
/Measurement Unit/Q21: U502.13 (Q7); also elsewhere on the board
/Measurement Unit/Q22: U502.12 (Q8); also elsewhere on the board
/Measurement Unit/Q23: U502.14 (Q9); also elsewhere on the board
/Measurement Unit/Q24: U502.15 (Q10); also elsewhere on the board
/Measurement Unit/Q25: U502.1 (Q11), U503.10 (CLK); also elsewhere on the board
/Measurement Unit/Q26: U503.9 (Q0); also elsewhere on the board
/Measurement Unit/Q27: U503.7 (Q1); also elsewhere on the board
/Measurement Unit/Q28: U503.6 (Q2); also elsewhere on the board
/Measurement Unit/Q29: U503.5 (Q3); also elsewhere on the board
/Measurement Unit/Q30: U503.3 (Q4); also elsewhere on the board
/Measurement Unit/Q31: U503.2 (Q5); also elsewhere on the board
/Measurement Unit/RESET: U501.11 (Reset), U502.11 (Reset), U503.11 (Reset); also elsewhere on the board
GND: CD501.2, CD502.2, CD503.2, U501.8 (VSS), U502.8 (VSS), U503.8 (VSS); also elsewhere on the board

Notes on the sheet:
30-bit Counter Module

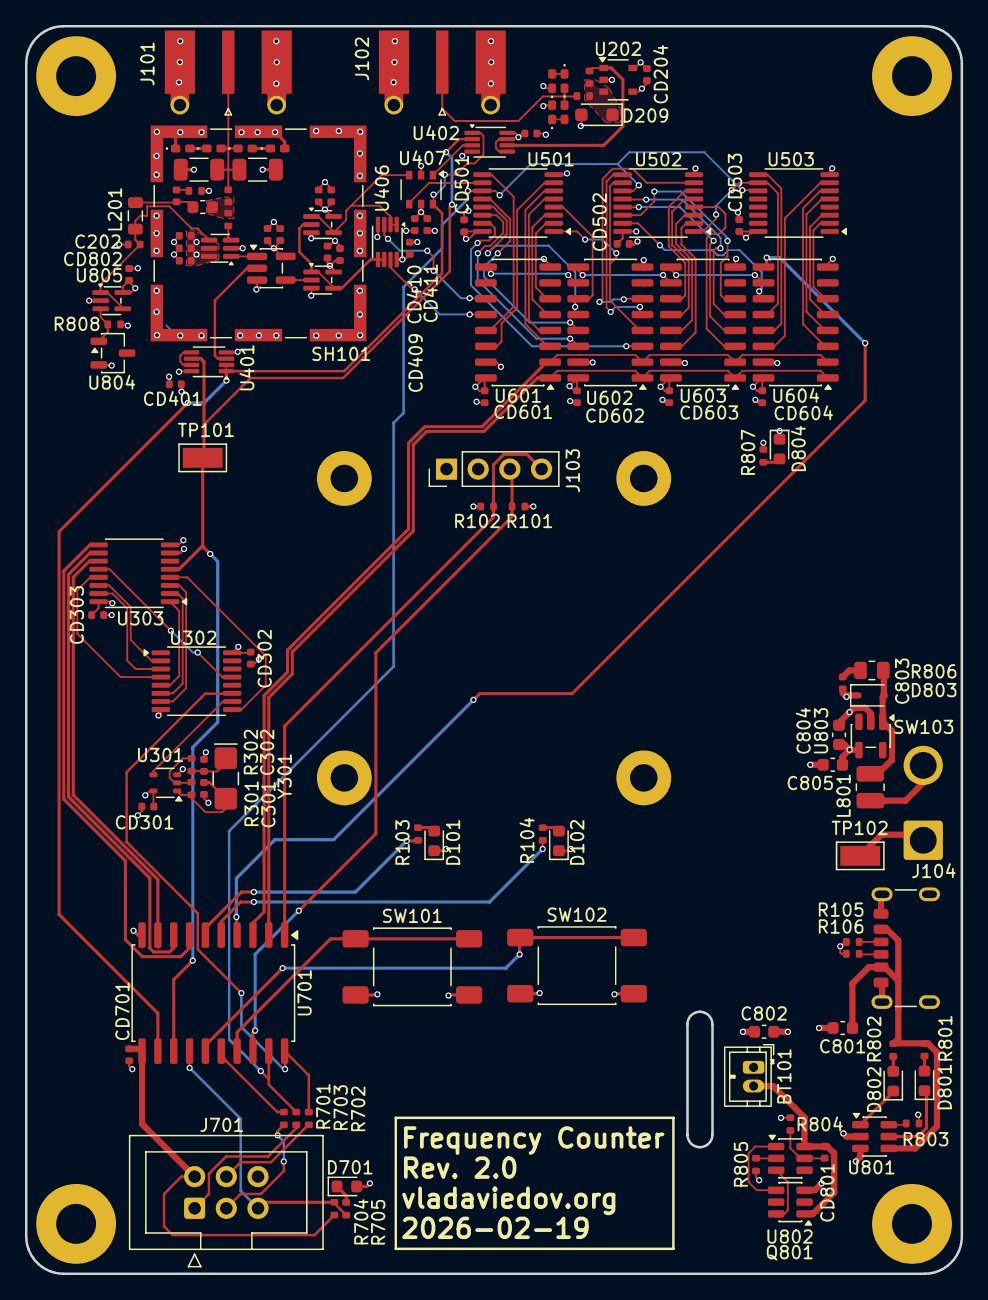
[picture p9: board frequency_counter.kicad_pcb from above]

Board: 4 copper layers, 75.0 x 100.0 mm, 131 parts (0 on the bottom side), 114 nets.
