vladaviedov/frequency-counter/(commit log)

2025-12-25 add design files for rev 1.0
    [frequency_counter.kicad_pcb, frequency_counter.kicad_sch, frontend.kicad_sch, measurement_unit.kicad_sch, microcontroller.kicad_sch, power_supply.kicad_sch, reference_clock.kicad_sch, serializer.kicad_sch]
2025-12-25 add pcb release for rev 1.0
2025-12-26 rework isp header, update pinout
    [frequency_counter.kicad_sch, frontend.kicad_sch, measurement_unit.kicad_sch, microcontroller.kicad_sch, power_supply.kicad_sch, reference_clock.kicad_sch, serializer.kicad_sch]
2025-12-26 add i2c pullups, fix power switch + tp, update block
    [frequency_counter.kicad_sch]
2026-02-17 redesign pierce oscillator
    [reference_clock.kicad_sch]
2026-02-17 split frontend into two channels
    [frequency_counter.kicad_sch, frontend.kicad_sch, measurement_unit.kicad_sch, microcontroller.kicad_sch, power_supply.kicad_sch, reference_clock.kicad_sch, serializer.kicad_sch]
2026-02-17 swap encoder for two buttons, assign channel select pin
    [frequency_counter.kicad_sch, microcontroller.kicad_sch]
2026-02-18 ch a voltage reference, ch b hysteresis
    [frequency_counter.kicad_sch, frontend.kicad_sch, power_supply.kicad_sch]
2026-02-18 rework frontend, channel gating
    [channel_gate.kicad_sch, frequency_counter.kicad_sch, frontend.kicad_sch, measurement_unit.kicad_sch, microcontroller.kicad_sch]
2026-02-18 replace alum caps with ceramics, change mpn labeling
    [channel_gate.kicad_sch, frequency_counter.kicad_sch, frontend.kicad_sch, measurement_unit.kicad_sch, microcontroller.kicad_sch, power_supply.kicad_sch, reference_clock.kicad_sch, serializer.kicad_sch]
2026-02-19 finish 2.0 part selection
    [channel_gate.kicad_sch, frequency_counter.kicad_sch, frontend.kicad_sch, measurement_unit.kicad_sch, microcontroller.kicad_sch, power_supply.kicad_sch, reference_clock.kicad_sch, serializer.kicad_sch]
2026-02-19 assign references
    [channel_gate.kicad_sch, frequency_counter.kicad_sch, frontend.kicad_sch, measurement_unit.kicad_sch, microcontroller.kicad_sch, power_supply.kicad_sch, reference_clock.kicad_sch, serializer.kicad_sch]
2026-02-19 minor fixes, 2.0 schematic
    [channel_gate.kicad_sch, frequency_counter.kicad_sch, frontend.kicad_sch, measurement_unit.kicad_sch, microcontroller.kicad_sch, power_supply.kicad_sch, reference_clock.kicad_sch, serializer.kicad_sch]
2026-02-19 redesign pcb for 2.0
    [channel_gate.kicad_sch, frequency_counter.kicad_pcb, frequency_counter.kicad_sch, measurement_unit.kicad_sch, power_supply.kicad_sch]
